calphool/Judicom/hardware/freecad/enclosure/Judicom.FCStd

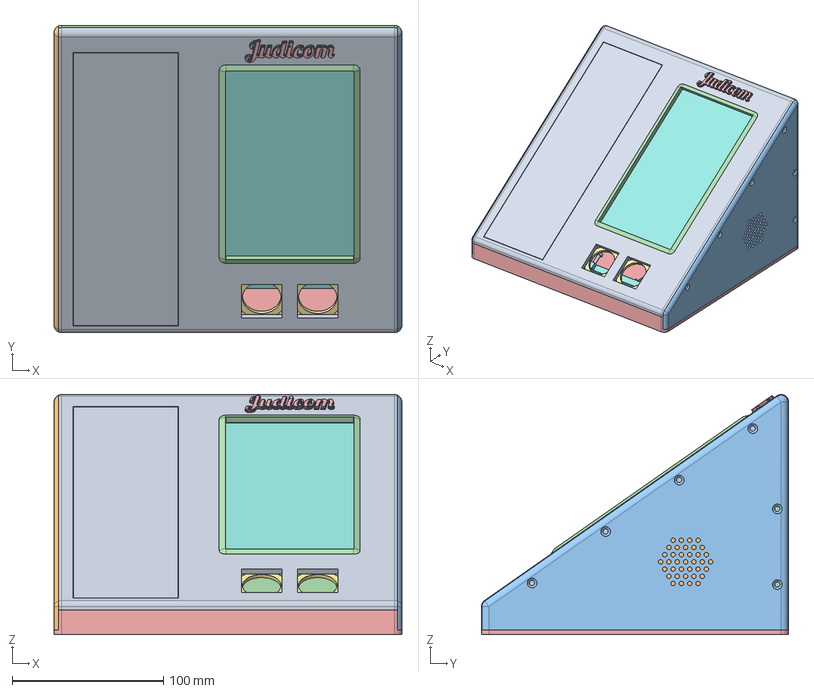
[picture p2: CAD file, 2026-11-06]
hardware/freecad/enclosure/Judicom.FCStd
230.0 x 203.1 x 158.6 mm
Panel
SideLeft
SideRight
Back
BottomPlate
PhoneJackCap
ButtonBracket
ButtonBarDirect
REF_ScrewsU
HangupAdapter
HookSwitchInsert
ScreenBezel
Lettering
PiCradle
REF_Pi3Aplus
REF_ScreenModule
REF_Cradle
REF_Speaker
REF_DCJack
REF_PhoneJack
REF_HookSwitch
