calphool/Judicom/hardware/freecad/hdmi screen/HDMI_Screen.pdf

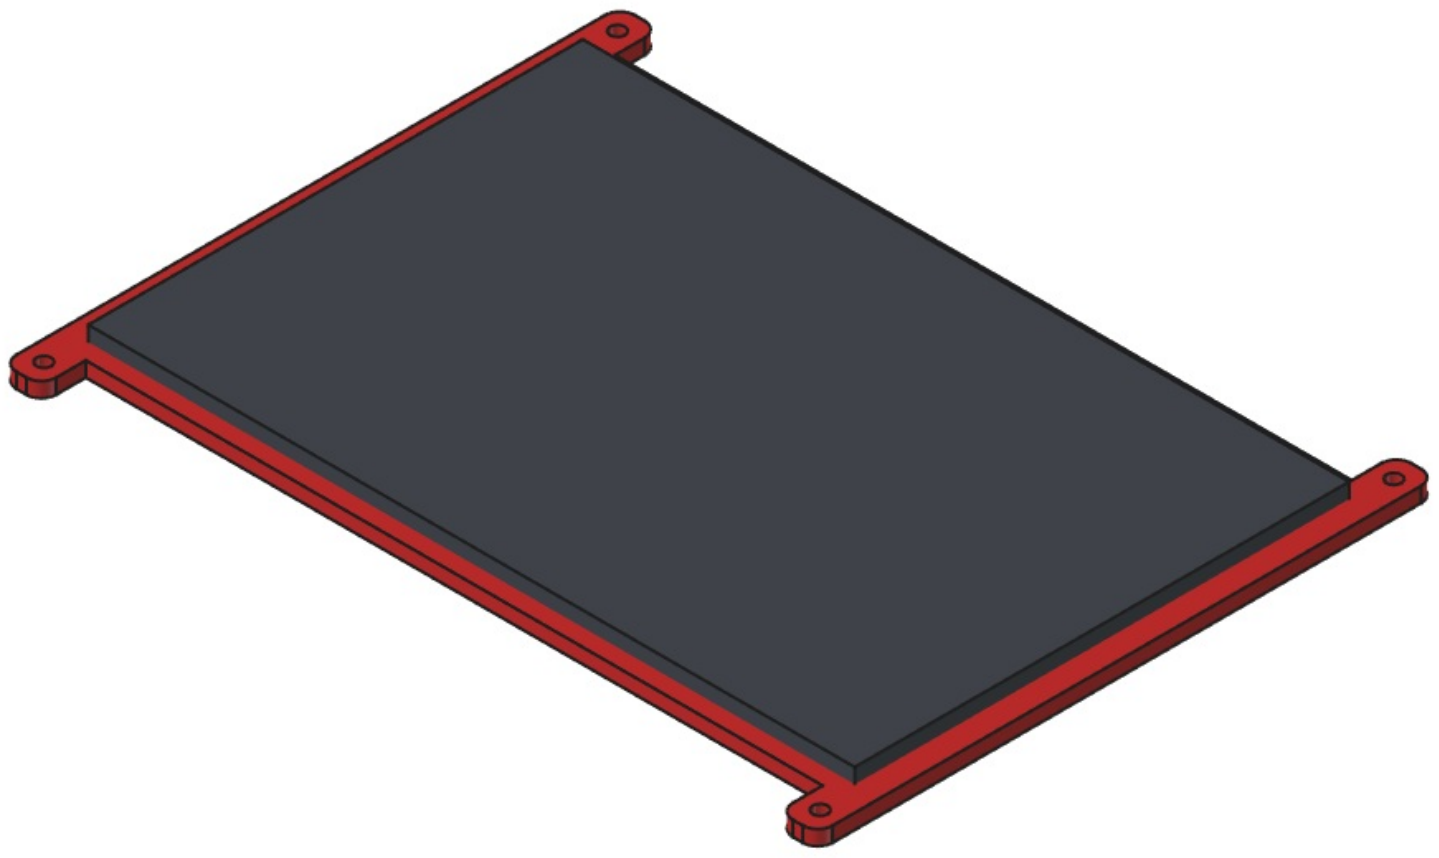
[picture p3: page 1]
