calphool/Judicom/hardware/freecad/prototype enclosure/Judicom.pdf

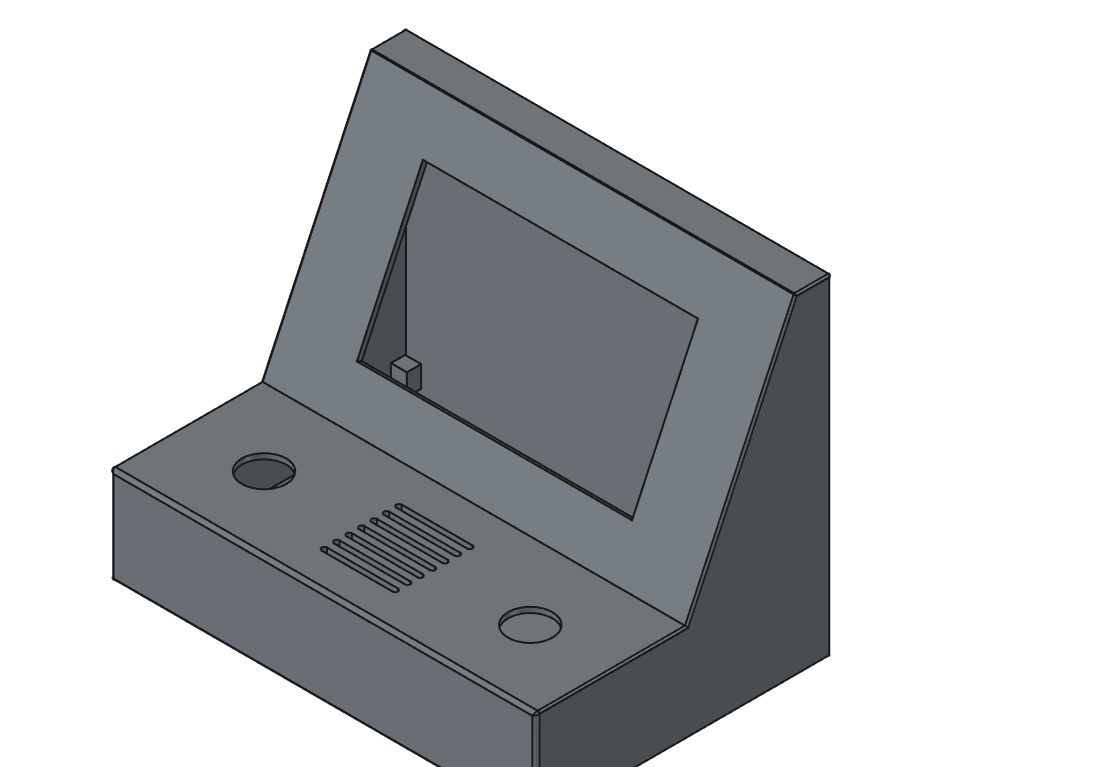
[picture p4: page 1]
