calphool/Judicom/(commit log)

2026-11-02 added enclosure documentation
2026-11-02 update to button hardware mounts
2026-11-03 Add hook/button inputs and phone state machine
    inputs.py: debounced events from the 3-contact hook switch (majority vote,
    wiring-fault warning) and the two buttons; keyboard stand-in on a PC.
    machine.py: pure state machine for the phone modes, emitting dial/answer/
    hangup/reject actions for the future call layer.
2026-11-03 Play touch-tone digits in the handset before a call goes out
    A button press now enters a DIALING phase: the button's digits play once
    as real DTMF on the handset card (after the dial tone has released it),
    and only when they are done does the machine send dial to the phone
    software. Hanging up while dialing sends nothing. The screen shows
    'Calling ...' throughout. Digits come from BUTTONS[...]['tones'], or the
    digits of 'dial'; only ordinary phone keys (0-9 * #) are ever played.
    Tests decode the generated audio back to digits with a Goertzel filter.
2026-11-03 Read the buttons' people and incoming caller names from a contacts file
    contacts.py reads /home/joe/contacts.txt on the Judicom (number | name |
    relationship | button), kept out of git because the repo is public. The
    buttons dial, and play the touch-tones of, the listed numbers; incoming
    numbers (any format, including SIP URIs) are matched to a name, and
    unknown ones show the formatted number. The file is re-read within a few
    seconds of a change. Without it the demo people in config.py are used.
    New demo key u = incoming call from an unlisted number.
2026-11-03 Demo key i: show the right button's person even without a contacts file
    Without a contacts file the demo people in config.py have no phone
    number, so 'i' fell back to the unknown-number caller instead of the
    right button's person its help text promises.
2026-11-03 Connect calls to baresip through its ctrl_tcp interface
    calls.py talks netstring-framed JSON to baresip on 127.0.0.1:4444: the
    machine's dial/answer/hangup/reject become dial/accept/hangup commands,
    and CALL_INCOMING/ESTABLISHED/CLOSED become incoming/answered/remote_ended
    events. Only the current call's events count, so a late close from an
    earlier call cannot end the next one. If baresip is down, a dial fails
    at once and the connection is retried every 5 s; losing baresip during a
    call ends it. main.py uses baresip by default (--no-calls to skip).
    python3 -m judicom.calls [--dial N | --answer] prints raw baresip
    messages for testing on the hardware.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
2026-11-04 Add systemd services so the Judicom starts by itself at power-on
    judicom-baresip runs baresip as joe after Tailscale (restarting until
    tailscale0 exists); judicom-phone runs judicom.main after the boot
    splash, with the video/render/input/gpio/audio groups. Both restart on
    failure. install_services.sh / uninstall_services.sh set them up.
2026-11-04 Make the NAS the single source of Judi's caller list
    /home/pi/judicom/contacts.txt on the NAS is now the only list to edit.
    deploy/nas/judicom/apply_contacts.py (pi's cron, every 10 min) writes
    Asterisk's judicom-allowed.conf from it and reloads the dialplan only on
    a change; an unreadable or empty list changes nothing. On the Judicom,
    judicom.sync (judicom-contacts-sync timer, at boot + every 10 min)
    fetches the same file over Tailscale with a key the NAS restricts to
    reading it, validates it, and replaces ~/contacts.txt atomically,
    keeping the old list if anything is wrong.
2026-11-04 Copy the family photos from the NAS every hour
    judicom.photo_sync (judicom-photo-sync timer: 2 min after boot, then
    hourly) mirrors /mnt/8tbdrive/Photos/Judi on the NAS into ~/photos with
    rsync over Tailscale, using its own key that the NAS limits to
    'rrsync -ro' of that folder. It changes nothing when the NAS can't be
    reached, when the folder has no pictures, or when more than half of the
    pictures would be removed (--force by hand). Tests run the real rsync
    through rrsync -ro, including a refused upload.
2026-11-04 baresip: no live call-status line (statmode_default off)
    During a call baresip rewrote a status line ten times a second with a
    carriage return; under systemd it piled up into one huge journal entry
    ([blob data]) that also swallowed the messages after it, such as the
    call ending.
2026-11-04 Add the info screen and the night clock
    When no call is on, home.py now rotates: 5 photos, then 30 s of the
    info screen (day, date, time, Springfield's weather from Open-Meteo, and
    the next 3 events, each with its date and a countdown: 'Christmas,
    December 25 (52 days to go)', 'Today!', 'Tomorrow', 'Sunday, 10:30 AM
    (5 days to go)'); from 9 pm to 6 am a dim night clock. Calls are
    unchanged and the night clock returns after one.
    The events list lives on the NAS (/home/pi/judicom/events.txt) and
    comes with the caller list every 10 minutes: the sync key's forced
    command becomes serve_list.sh, which answers 'contacts' (the default)
    or 'events' and refuses anything else. Weather fetches in a bac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
2026-11-04 Info screen: weather icon a little smaller and lower, clear of the place name
    The cloud touched the bottom of 'Springfield' by a few pixels; now every
    icon has at least 18 px below the name and 19 px above the card's edge
    (measured on all eight icons).
2026-11-04 NAS: hourly check that keeps VoIP.ms's address allowed if it ever changes
    voipms_address_check.py (root, voipms-address-check.timer) looks up
    chicago4.voip.ms and only ever ADDS new addresses: to the firewall's
    new 'voipms' set (live and in /etc/asterisk-firewall.nft) and to
    Asterisk's voipms-identify match= (then a pjsip reload). Lookups that
    fail or look wrong change nothing and log a WARNING. The install script
    checks the new rules with nft -c before loading them.
2026-11-04 Back up the Judicom's whole SD card to the NAS while it runs
    backup_judicom.sh stops the phone and syncs, moves the journal to memory,
    freezes the root partition (inner trap + 45 min safety timer unfreeze),
    and streams the card's start and boot partition (dd) plus the root
    partition's used blocks (e2image -ra, free space as zeros) through zstd
    to the NAS over the home network or Tailscale; then restarts everything
    and checks the copy's SHA-256 on the NAS. receive_backup.sh is the only
    thing the new backup key may run there: store / check / note, newest 5
    kept, refused below 40 GB free. (backup_sd_card.sh: the same from a
    card reader.)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
2026-11-04 Backup: home network only, a watchdog inside the frozen part, and a trial run
    After the 2026-11-04 attempt froze the Judicom (route check fooled by
    pipefail -> Tailscale, which stalls on the frozen root; the stream did
    not end after ssh timed out, so nothing unfroze; sudo cannot start while
    frozen): the frozen part is now backup_stream.sh, which unfreezes on
    every exit (incl. INT/TERM/HUP), has a watchdog started before the
    freeze that ends the copy after 15 min, and an independent guard at
    20 min. Tested with stand-in tools, incl. a reader that stops reading
    (unfrozen 4.1 s later). The backup refuses to run unless the NAS
    answers on the home network. --trial measures speed and image size an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
2026-11-04 Backup: e2image -f (it refuses a read-write mounted partition otherwise)
    The trial stopped silently at its size measurement: e2image -r exits 1
    on a partition mounted read-write unless -f is given. Frozen, the
    partition cannot change, so -f is sound for the backup; the trial's
    size estimate is unaffected by consistency. e2image's messages are no
    longer hidden, and the script now says where it stopped on any error.
2026-11-04 Updated enclosure freecad model
2026-11-04 Backup: read the frozen root through a loop device; verified commit on the NAS
    Why the 2026-11-04 backup stalled: e2image's mount check creates
    /.ismount-test-file on the root it is given, which blocks on a frozen
    filesystem (found with strace). backup_stream.sh now reads partition 2
    through a read-only, direct-I/O loop device (no mount check, nothing
    stale from memory) and dd reads with iflag=direct. It restarts the
    phone itself right after unfreezing (no sudo needed later). The trial
    adds a 200 MB e2image read of the frozen card.
    NAS receive_backup.sh: store keeps a hidden .part; 'commit NAME SUM'
    gives it its real name only if the SHA-256 (now of the compressed
    stream, cheap on the Pi) m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
2026-11-04 copy_used_blocks.py: an e2image -ra replacement without the mount check
    e2image's mount check creates /.ismount-test-file on a root partition,
    which blocks forever when it is frozen; a loop device does not hide the
    mount (libext2fs follows loops to their backing device) and dm-linear
    refuses a mounted partition. This copies the used blocks (from
    dumpe2fs's free-block lists) and writes zeros for the free ones,
    dropping cached pages first. Tested against e2image -ra on file systems
    with junk in their free space: identical except that it also keeps the
    backup superblocks and group descriptors as they are on disk (e2image
    zeroes them); the copy passes e2fsck with files intact.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
2026-11-04 Backup: copy the frozen main partition with copy_used_blocks.py, not e2image
    backup_stream.sh: the loop device is gone; the main partition is read
    by copy_used_blocks.py (dumpe2fs + used blocks, free as zeros; python
    with PYTHONDONTWRITEBYTECODE). trial-read uses the copier with a 3 min
    watchdog, so a block shows up fast. On the Judicom, unfrozen: dumpe2fs
    opens nothing for writing (strace), the copier reads 12 MB/s on the
    dense first 1.5 GB. End to end with a real ext4 test image: restored
    image = card start + the copier's output, valid fs, free space zeros.
2026-11-04 Keep the Judicom's system log on the card, for one day at most
    Raspberry Pi OS sets Storage=volatile, so a restart erased the log of
    what came before it. journald-judicom.conf (installed by
    install_services.sh as journald.conf.d/90-judicom.conf, overriding
    40-rpi-volatile-storage.conf): persistent, hourly files, entries kept
    1 day, at most 50 MB, 1 GB always left free. ~2000 lines/hour, so a
    day is a few MB. The backup already moves the log to memory while the
    card is frozen (relinquish-var / flush).
2026-11-04 Photo sync: copy only pictures the Judicom can show, and .meta captions
    The mail importer also saves videos (.mp4/.mov) and .heic/.gif into
    Judi's NAS folder; the hourly sync copied everything, so a few phone
    videos could fill the card although the Judicom cannot show them.
    rsync now includes only .jpg/.jpeg/.png/.bmp (any case) and .meta,
    with --delete-excluded to remove anything else already here; the
    safety checks count only those files. Tested with real rsync through
    rrsync -ro. (Space audit: journal capped, logrotate active, no core
    dumps, apt cache static, Tailscale state 108 KB.)
2026-11-05 ring_test: --pin PIN=0|1 sets GPIO pins before ringing (switch pins refused)
2026-11-05 Out-of-order screen: a button pressed while the phone cannot reach the PBX says so instead of dialing
2026-11-05 Info screen: pictures for 23 more family days (cat hug, veggies, life ring, jack-in-the-box, sloth, parrot, UFO, monkey ...)
2026-11-06 Website events page: a button that sorts each section by date (Easter, Thanksgiving ... by this year's date) and saves
2026-11-06 tools/touch_draw.py: draw on the screen with your fingers (a button or the handset ends it); the ringer amplifier is a PAM8403, not an LM386
2026-11-06 adjustments to PI mounting
2026-11-06 performance improvement for freecad enclosure macro
2026-11-06 Backup: a progress log in memory, and the copy gives up after 15 minutes (the guard after 20), under the 30 of the offline alert
    On 2026-11-06 a copy stalled after 347 MB with the card frozen, and nothing recorded which stage had stopped.
2026-11-06 Messages for Judi from See Judicom Now: a speech bubble with a caller's face and three beeps, until a touch, a button or the handset
    They wait for calls and for the morning, and the page says when she has read them. The phone program now reads the touch screen
    (judicom/touch.py, moved from tools/touch_draw.py). The NAS's key asks through tools/nas_request.py.
2026-11-06 Backup: zstd in one thread, every thread and its kernel stack in the progress log when the card stops being read, limits of 25 and 28 minutes
2026-11-06 Backup: zstd really in one thread (--single-thread alone keeps two for reading and writing)
2026-11-07 Maintenance shell on the Judicom's own screen, and the touch panel comes back after a USB dropout
    Both buttons held for 3 seconds with the handset down, then the four corners clockwise, with a rising
    bong for each step, open a real bash on a pseudo-terminal with a touch keyboard. "exit" or 10 minutes
    without a key goes back to the photos. It runs inside the phone program, so calls still work. Needs
    python3-pyte; without it the phone runs as usual.
    Taps.poll() now returns where fingers came down, and a missing panel is looked for every 5 seconds.
2026-11-07 Touch: a press the panel reports twice is one tap
    The panel reports nearly every press as down, up after 0.1 s, and down again 0.07 to 0.16 s later in
    the same place, which ended the maintenance sequence at its second corner. A touch within 0.25 s and
    50 pixels of a finger going up is now that same press.
2026-11-07 Lifted screen: a small picture of whoever is on each button, over their name; only the arrows bob now
2026-11-07 Housekeeping website: an idle connection no longer stops the HTTPS server
    The server shook hands in its one accepting loop, so a spare connection held open by a browser stopped
    the website for everybody. Each connection now shakes hands in its own thread, and one that says
    nothing for 60 seconds is dropped.
2026-11-08 Ringer amplifier on GPIO 25: on while the speaker plays, off a second after
    The phone switches the MOSFET on before the ringer, a message's beeps or a bong, and off once the
    speaker has been quiet for a second, holding the pin low the rest of the time. The ringer test
    switches it on by itself, and --pin 25=0 checks that it is off.
2026-11-08 Docs: why the ringer's amplifier is switched on and off (its noise between sounds), and how to check it
2026-11-10 Hardware notes: the handset mic plug's wiring (the adapter's sleeve is ground), and how to check the mic
2026-11-10 Asterisk: the container is "asterisk" in /home/pi/asterisk, the dialplan file voipms-dialplan.conf (no more "test" names)
    The Judicom's messages and Asterisk's logs (call history) are now mounted from ./sounds-custom and ./log instead of living in
    Docker's unnamed volumes, so a new container keeps them and the weekly /home/pi backup copies them. The mic test's beep moved
    to custom/beep for the same reason.
2026-11-10 One reading of the caller list (judicom/callers.py), shared by the Judicom, apply_contacts.py and the housekeeping website
    The three copies of the parser are gone: contacts.py and apply_contacts.py read with callers.read(), the website reads its
    form rows with callers.fields() and cleans numbers with callers.normalize/pretty (its stricter saving rules stay its own).
    On the NAS /home/pi/judicom/apply_contacts.py becomes a link into the repository clone. Checked on the real lists: the
    same allowed list and the same people and buttons as before.
2026-11-10 Docs: the Judicom is a Pi 3 A+, and the handset audio, hook switch and ringer amplifier are in use, not proposed
    HARDWARE.md gains the GPIO table (hook switch 17/27/22, buttons 23/24, amplifier 25), the parts actually fitted (C-Media
    USB adapter, HS-007 panel, USB touch), the electret that replaced the Merlin's microphone, and the under-voltage the Pi
    reported. ARCHITECTURE.md and DECISION.md drop the "proposed" and "inbound untested" states and the settled questions.
2026-11-10 Docs: the buttons are 27 mm square photo arcade buttons, as in the FreeCAD model, not 60 mm round ones
    HARDWARE.md's mechanical notes now come from judicom_freecad_macro.py: body 230 x 203 x 160, screen window 87 x 154,
    button holes 27 x 27 with centres 37 mm apart (what BUTTON_X in config.py already assumed), the 3 mm short-throw parts,
    the BIS-10 hook switch, the speaker on a 42 mm square, the Pi in its cradle. The round buttons' sizes, their LEDs and
    the old 50 mm base are gone.
2026-11-10 Docs: when the Judicom's under-voltage dips happened (right after a lift or a ring), and the buttons are not lit
2026-11-10 Docs: the build-time notes go (checklists, "confirm before final print", open questions); what is left is how it is
    HARDWARE.md: the enclosure and power as built, no validation checklist or assumed-dimension caveats; the under-voltage
    dips become a known problem, and GPIO 25 is described as wired (no gate pull-down). DECISION.md loses its open
    questions, ARCHITECTURE.md its "still to validate". software/README: no "Step 1-4" headings; README: what the touch
    screen is used for.
2026-11-10 Docs: GPIO 25 is held low from power-on by gpio=25=op,dl in the Judicom's config.txt
2026-11-11 FreeCAD macro: only the Raspberry Pi 3A+ (the stale 3B+ notes are gone)
2026-11-14 Docs: the under-voltage dips are fixed (soft start on the amplifier, heavy micro-USB cable); load test results
2026-11-14 Asterisk: pin the image to the exact working build (22.11.0, by digest); how to upgrade on purpose
2026-11-14 A hidden arcade game: the shell's knock with the corners counter-clockwise from the bottom right
    Raiders march and descend in a 5 x 11 formation behind four wearing shelters; buttons move the turret, both fire. Fixed 60 Hz
    steps, drawn on a 200 x 341 canvas scaled straight into the screen; its own sounds through one mixed aplay on the ringer
    speaker, stopped before the ringer. Lifting the handset or a call ends it. High score kept in ~/.judicom-game-best.
2026-11-14 A hidden menu behind the maintenance knock: Shell, Invaders, Back to the photos
    The counter-clockwise game knock is gone; the clockwise knock opens the menu and a touch picks. Games are a list in main.py
    (label -> session with step / draw / close), so the next one is one more line; the buttons shrink to fit more.
2026-11-14 Brick Breaker on the hidden menu
    Paddle, ball and 112 bricks in a 480 x 640 world: swept ball movement (2 px substeps, circle-rectangle collisions) so nothing
    tunnels; paddle angle off the contact point (up to 60 deg); quicker every 12 bricks and above the wall; launch and restart on a
    fresh press of both buttons, with 75 ms allowed between them. Drawn at 9/16 on a half-screen canvas (even brick gaps, square
    pixels). game.Session now takes any game, view and sound set.
2026-11-14 Meteoroids on the hidden menu
    A wrapping field of splitting rocks and occasional enemy craft, with a turn / tap-to-fire / hold-to-thrust two-button state
    machine. Drawn in lines straight onto the screen (Display.mapper, Session.present) rather than as a turned picture.
    Fixes found in play: a quick tap overlapping for one frame now fires, and a new ship can fire at once (the shot gap used
    the ship's own clock).
2026-11-14 Stellar Stronghold on the hidden menu
    A cannon behind three counter-turning rings of two-hit shield segments that grow back when a ring is cleared; the cannon
    fires through lined-up gaps (its path checked against the rings as they will turn); three mines hunt the ship and are
    stopped by intact segments. The ship and two-button controls move into meteor.Pilot, shared with Meteoroids.
    Menu icon of the three rings.
2026-11-14 Lunica on the hidden menu, and the menu in two columns
    Formation shooter: curving entries (two through the fighter's row), dives with shots and escorted commanders, capture
    beam and rescue into two fighters, bonus stages, extra fighters at 20,000 / 70,000 / every 70,000. Hold both to fire
    continuously. Its own tunes (a three-part C-major start, a rapid A-minor capture); coloured falling stars.
    The menu goes to two columns (picture over name) from seven entries. Game sessions keep sounds asked for in the few
    seconds before their sound is ready, and play them then.
2026-11-14 Plume Knights on the hidden menu
    A knight on a golden plume-bird jousts with riders on drakes over a molten
    lake: flap with both buttons, the higher lance wins, gather the eggs before
    they hatch. Survival and egg waves, a shore that crumbles, a fire serpent
    that rises at low flyers, and a raptor for waves that go on too long. A
    single button turns the knight only once held 0.12 s on its own, so a button
    let go late after a flap is no turn. Sprites, lava and sky are drawn once
    and kept as quick colour-keyed pictures: about 3.6 ms a frame on the Pi.
